williammp98/PI-VI_Retrofitt_Maquina_Laser/PI-VI_2022/Fotos/Fotos 10ª Semana/Peças impressas 4.jpeg

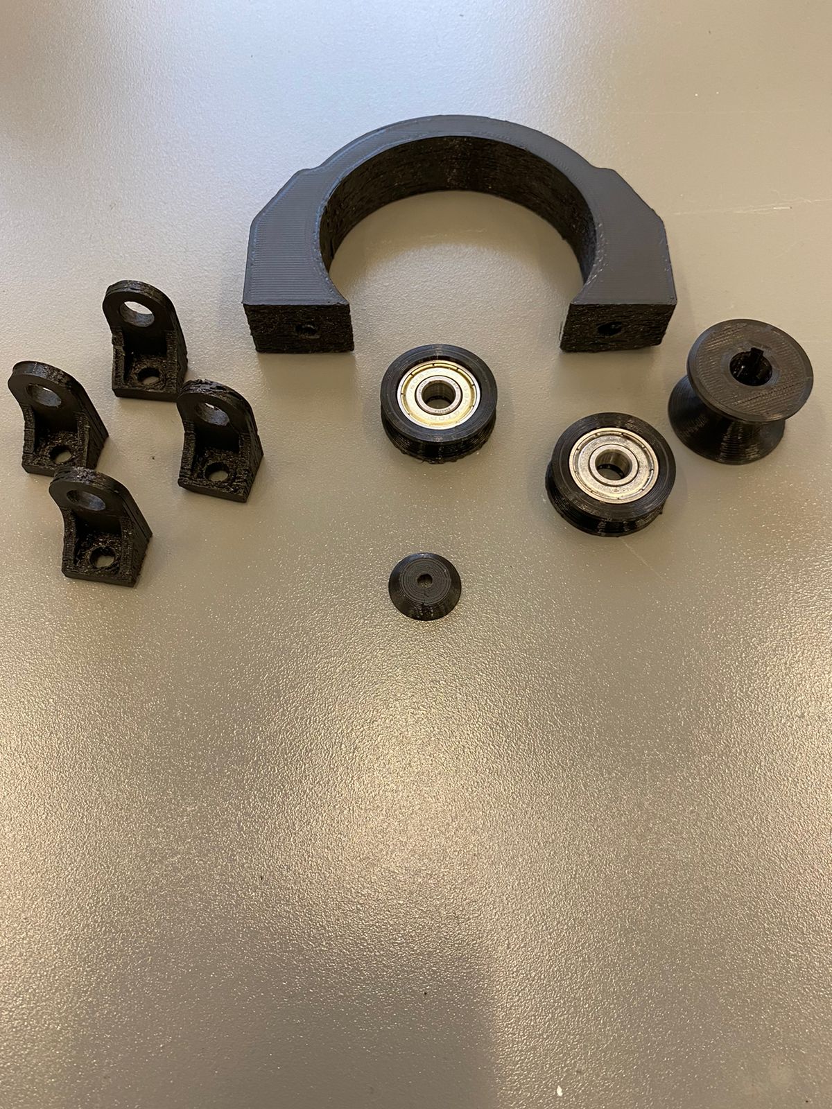
PI-VI_2022/Fotos/Fotos 10ª Semana/Peças impressas 4.jpeg
