williammp98/PI-VI_Retrofitt_Maquina_Laser/PI-VI_2022/Fotos/Fotos - Detalhado/WhatsApp Image 2022-07-19 at 16.29.12.jpeg

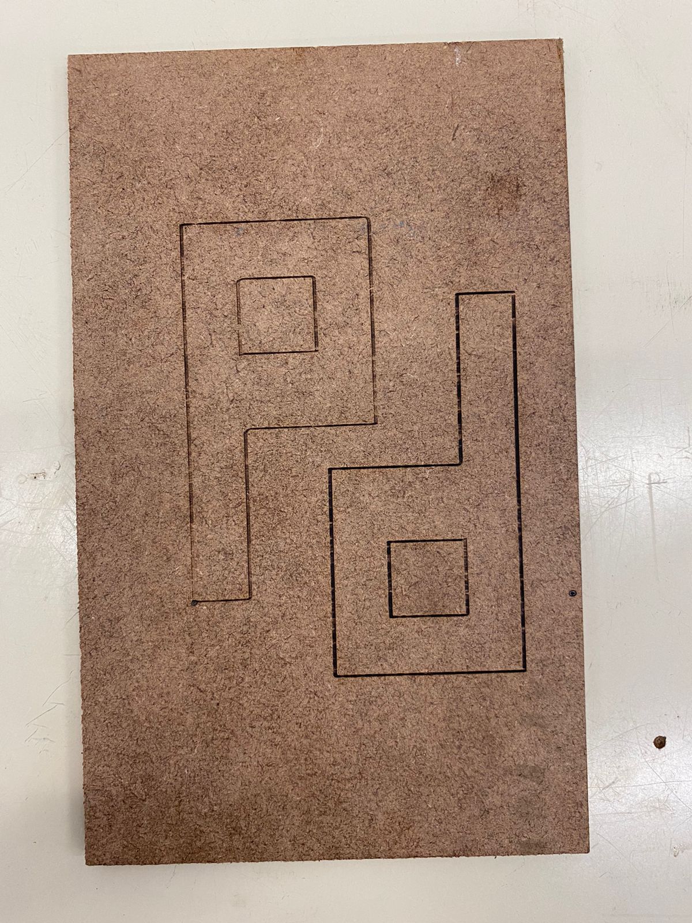
PI-VI_2022/Fotos/Fotos - Detalhado/WhatsApp Image 2022-07-19 at 16.29.12.jpeg
