williammp98/PI-VI_Retrofitt_Maquina_Laser/PI-VI_2022/Fotos/Fotos_1ªSemana/WhatsApp Image 2022-04-20 at 14.43.26 (1).jpeg

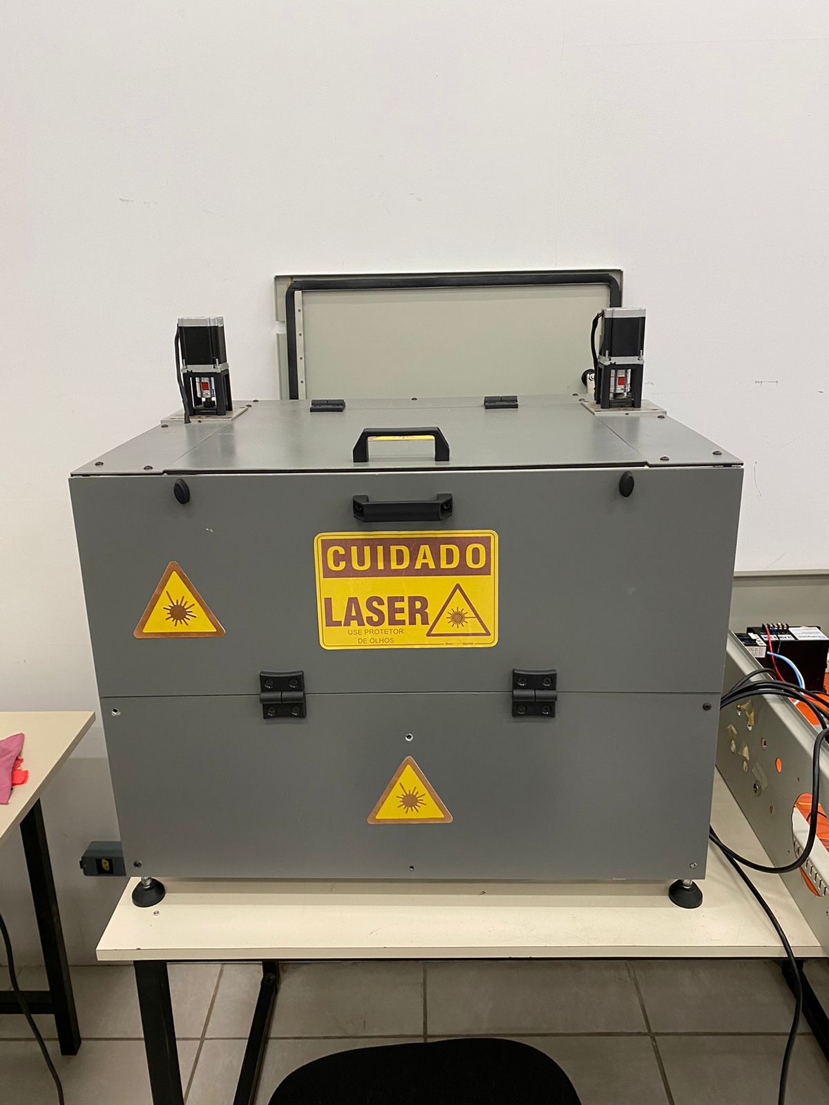
PI-VI_2022/Fotos/Fotos_1ªSemana/WhatsApp Image 2022-04-20 at 14.43.26 (1).jpeg
