williammp98/PI-VI_Retrofitt_Maquina_Laser/PI-VI_2022/Fotos/Fotos_3ªSemana/WhatsApp Image 2022-04-20 at 14.26.42.jpeg

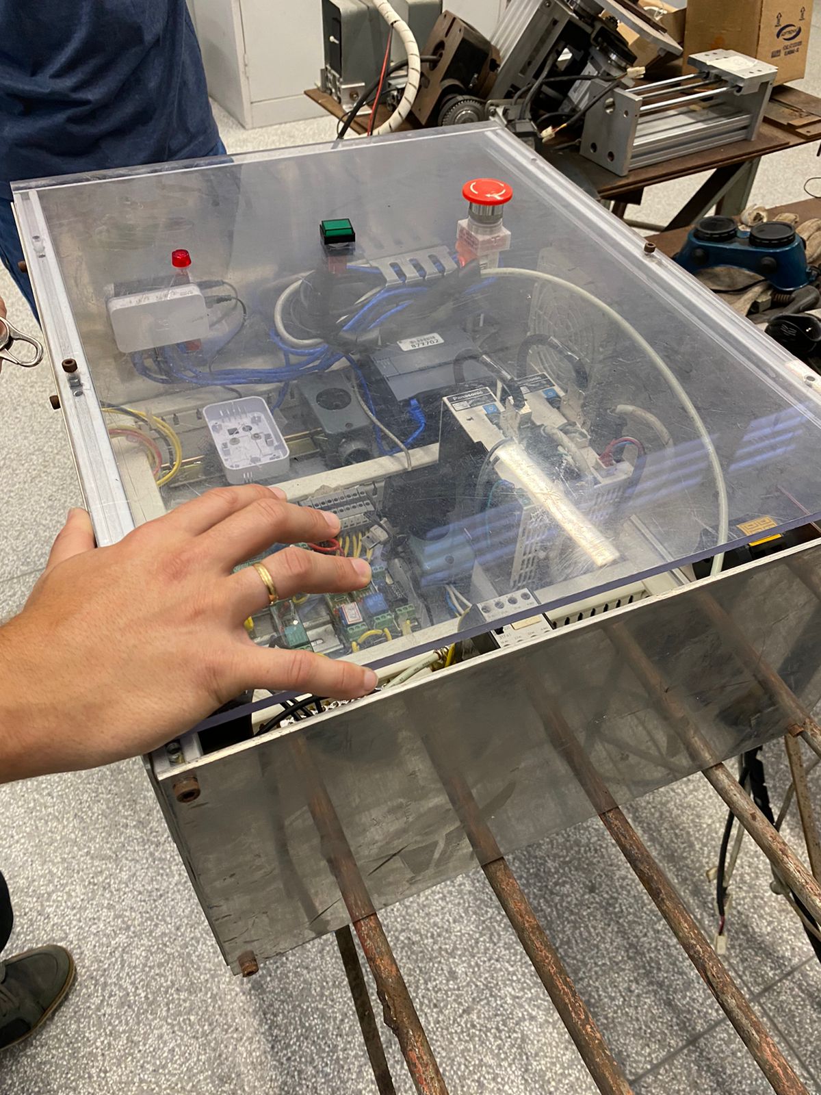
PI-VI_2022/Fotos/Fotos_3ªSemana/WhatsApp Image 2022-04-20 at 14.26.42.jpeg
