williammp98/PI-VI_Retrofitt_Maquina_Laser/PI-VI_2022/Fotos/Placas/WhatsApp Image 2022-07-20 at 17.30.32.jpeg

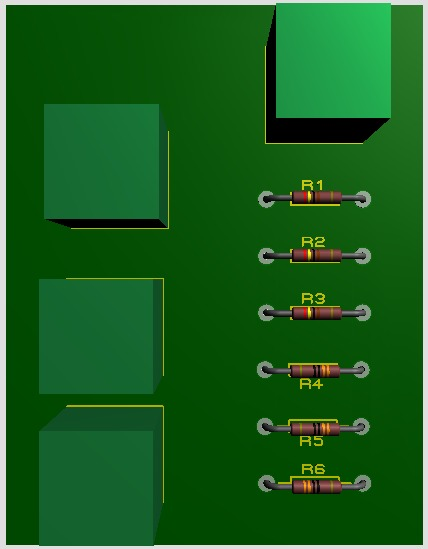
PI-VI_2022/Fotos/Placas/WhatsApp Image 2022-07-20 at 17.30.32.jpeg
