williammp98/PI-VI_Retrofitt_Maquina_Laser/PI-VI_2022/Peças CAD/Capturar.PNG

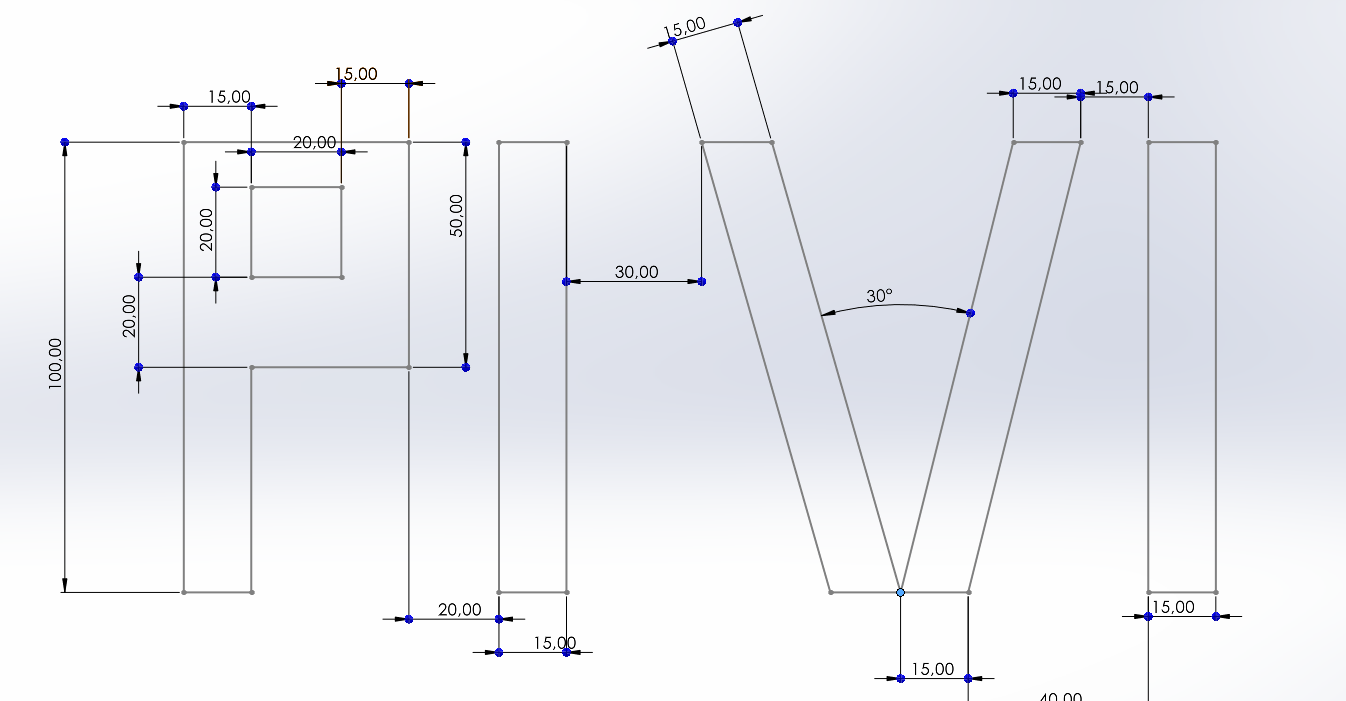
PI-VI_2022/Peças CAD/Capturar.PNG
