williammp98/PI-VI_Retrofitt_Maquina_Laser/PI-VI_2022/Fotos/Fotos principais componentes/20220504_143511.jpg

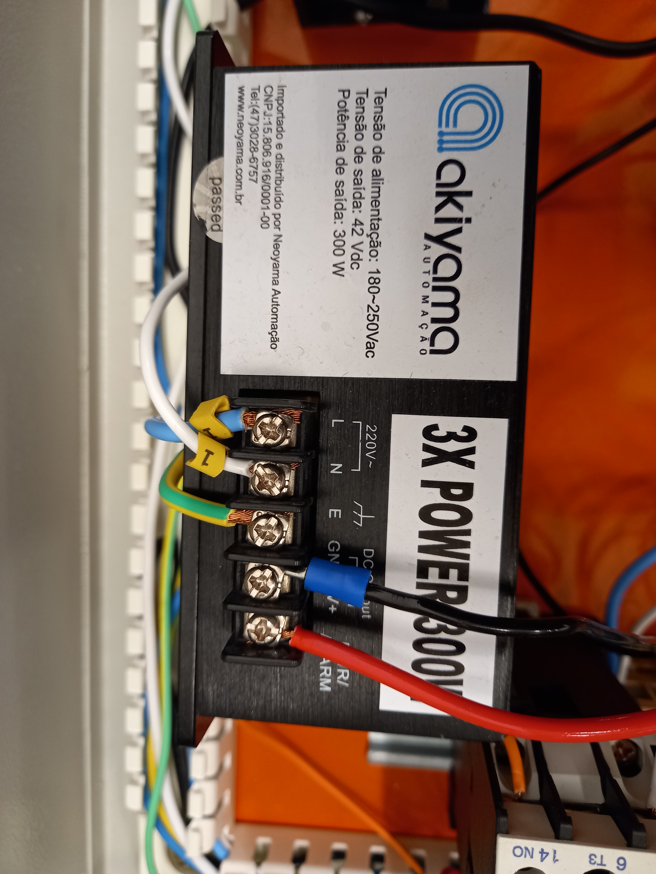
PI-VI_2022/Fotos/Fotos principais componentes/20220504_143511.jpg
