williammp98/PI-VI_Retrofitt_Maquina_Laser/PI-VI_2022/Peças CAD/cage.SLDPRT

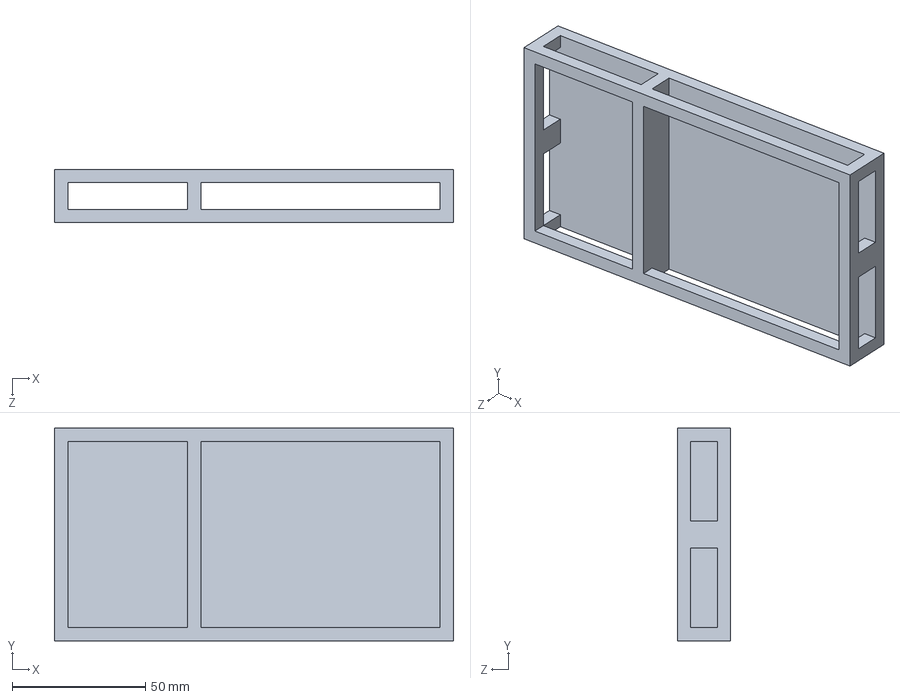
[picture p113: CAD file, 2022-07-20]
PI-VI_2022/Peças CAD/cage.SLDPRT
150.0 x 80.0 x 20.0 mm
