williammp98/PI-VI_Retrofitt_Maquina_Laser/PI-VI_2022/Peças CAD/polias maq laser/TAMPA CARRETEL.SLDPRT

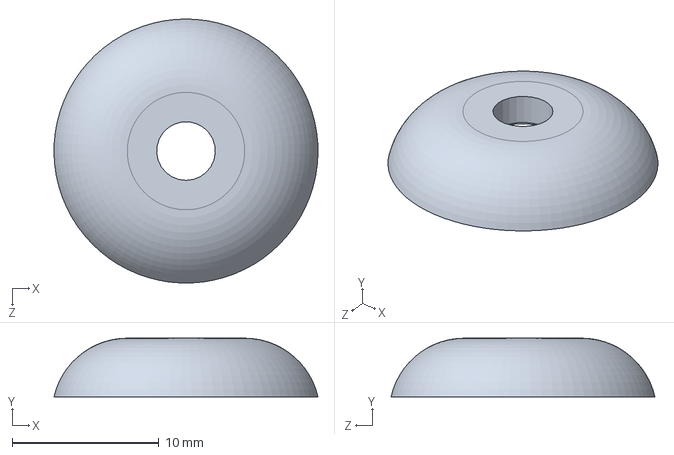
[picture p114: CAD file, 2022-07-20]
PI-VI_2022/Peças CAD/polias maq laser/TAMPA CARRETEL.SLDPRT
18.0 x 4.00 x 18.0 mm
