williammp98/PI-VI_Retrofitt_Maquina_Laser/PI-VI_2022/Peças CAD/polias maq laser/SUPORTE POLIA.SLDPRT

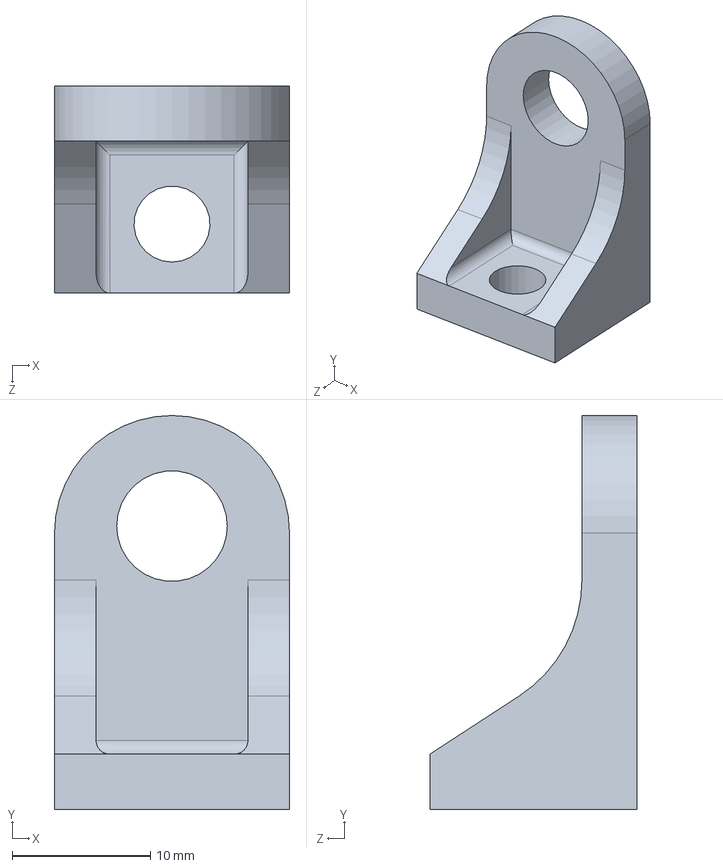
[picture p115: CAD file, 2022-07-20]
PI-VI_2022/Peças CAD/polias maq laser/SUPORTE POLIA.SLDPRT
17.0 x 28.5 x 15.0 mm
