williammp98/PI-VI_Retrofitt_Maquina_Laser/PI-VI_2022/Peças CAD/Suporte fim de cursop.SLDPRT

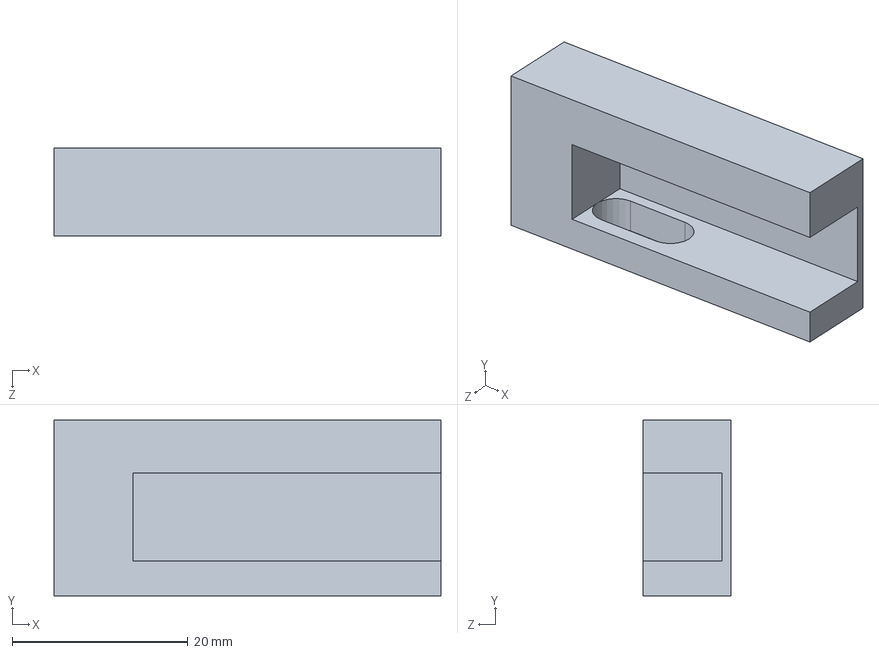
[picture p116: CAD file, 2022-07-20]
PI-VI_2022/Peças CAD/Suporte fim de cursop.SLDPRT
44.0 x 20.0 x 10.0 mm
