williammp98/PI-VI_Retrofitt_Maquina_Laser/PI-VI_2022/Peças CAD/polias maq laser/POLIA.SLDPRT

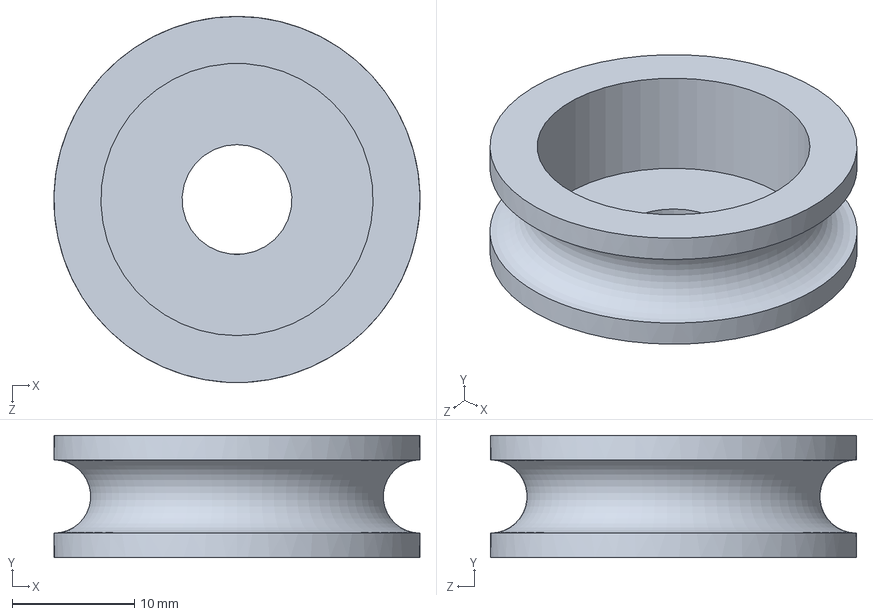
[picture p117: CAD file, 2022-07-20]
PI-VI_2022/Peças CAD/polias maq laser/POLIA.SLDPRT
30.0 x 10.0 x 30.0 mm
