williammp98/PI-VI_Retrofitt_Maquina_Laser/PI-VI_2022/Peças CAD/Peça2.STL

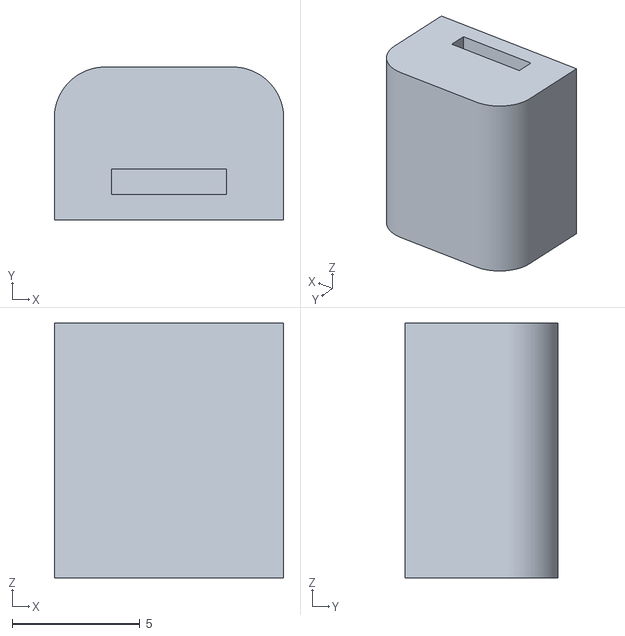
[picture p118: CAD file, 2022-07-20]
PI-VI_2022/Peças CAD/Peça2.STL
9.00 x 6.00 x 10.0
