williammp98/PI-VI_Retrofitt_Maquina_Laser/PI-VI_2022/Peças CAD/polias maq laser/Carretel motor.SLDPRT

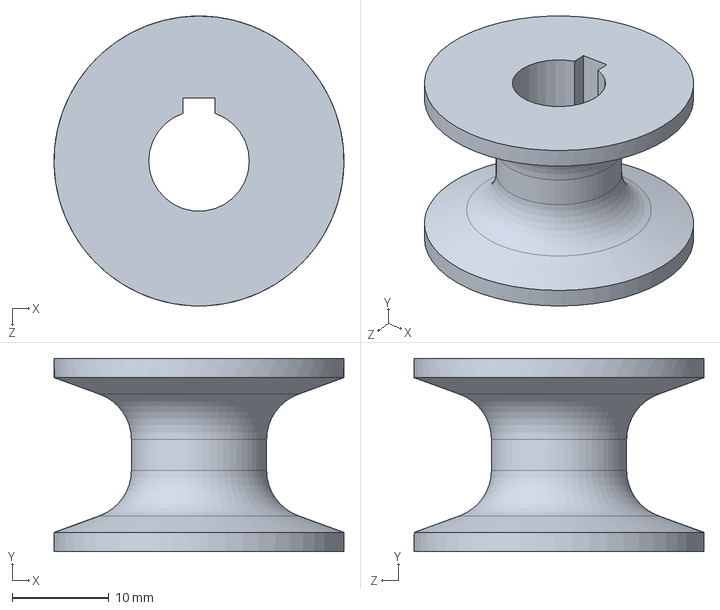
[picture p119: CAD file, 2022-07-20]
PI-VI_2022/Peças CAD/polias maq laser/Carretel motor.SLDPRT
30.0 x 20.0 x 30.0 mm
