williammp98/PI-VI_Retrofitt_Maquina_Laser/PI-VI_2022/Peças CAD/polias maq laser/MANCAL MOTOR.SLDPRT

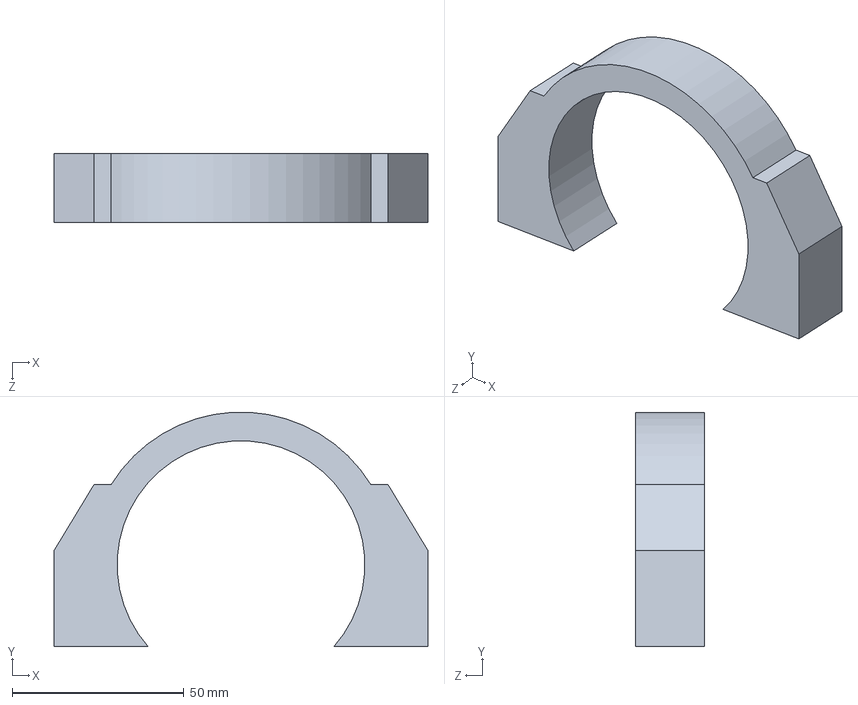
[picture p120: CAD file, 2022-07-20]
PI-VI_2022/Peças CAD/polias maq laser/MANCAL MOTOR.SLDPRT
109.0 x 68.3 x 20.0 mm
