williammp98/PI-VI_Retrofitt_Maquina_Laser/(list of files, cad)

Other CAD files:
PI-VI_2022/Peças CAD/Peça1.SLDPRT
PI-VI_2022/Peças CAD/Suporte fim de cursop.STL
PI-VI_2022/Peças CAD/polias maq laser/Carretel motor.STL
PI-VI_2022/Peças CAD/polias maq laser/MANCAL MOTOR.STL
PI-VI_2022/Peças CAD/polias maq laser/POLIA.STL
PI-VI_2022/Peças CAD/polias maq laser/SUPORTE POLIA.STL
PI-VI_2022/Peças CAD/polias maq laser/TAMPA CARRETEL.STL
